GuiGui2401/CleverTreeSystem/README.md

# CleverTreeSystem

An application for monitoring plantations coupled with a physical device and created for web and mobile platforms

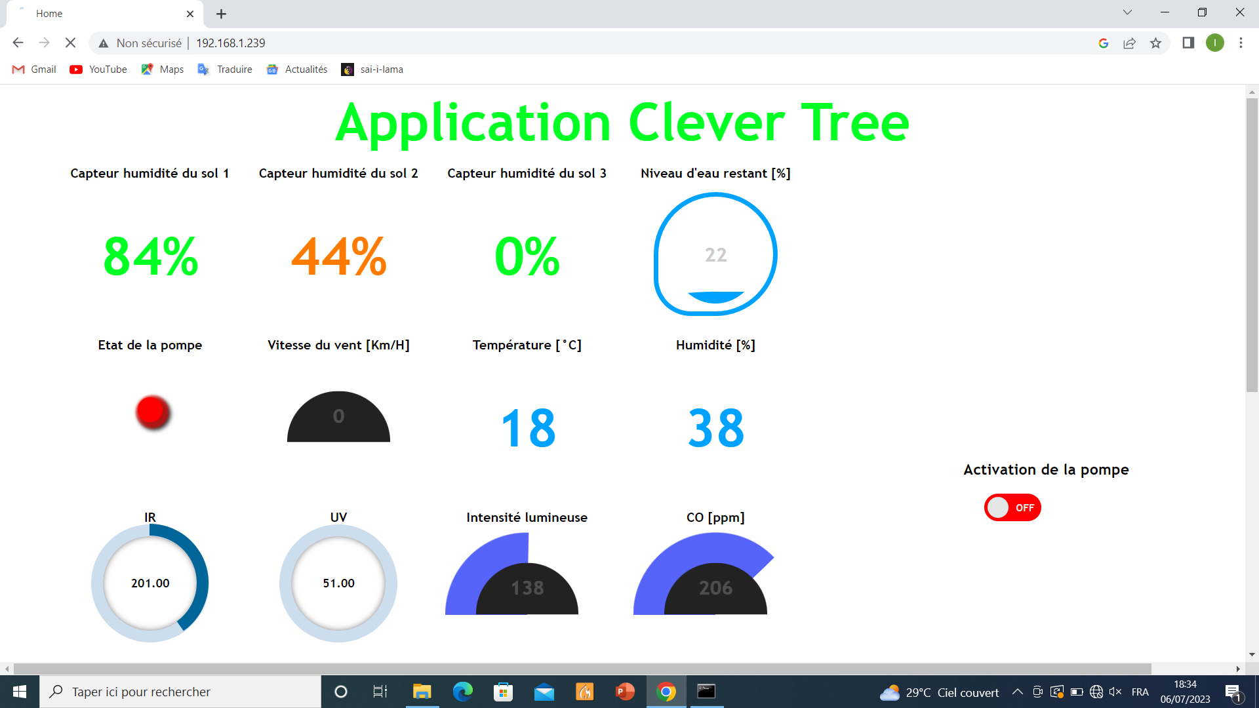
[picture p1: DOC/System_Test/Capture2.PNG]


- Made with Arduino, Java Android and Native Web integrated into Arduino language 💙

## That's the electrical diagram

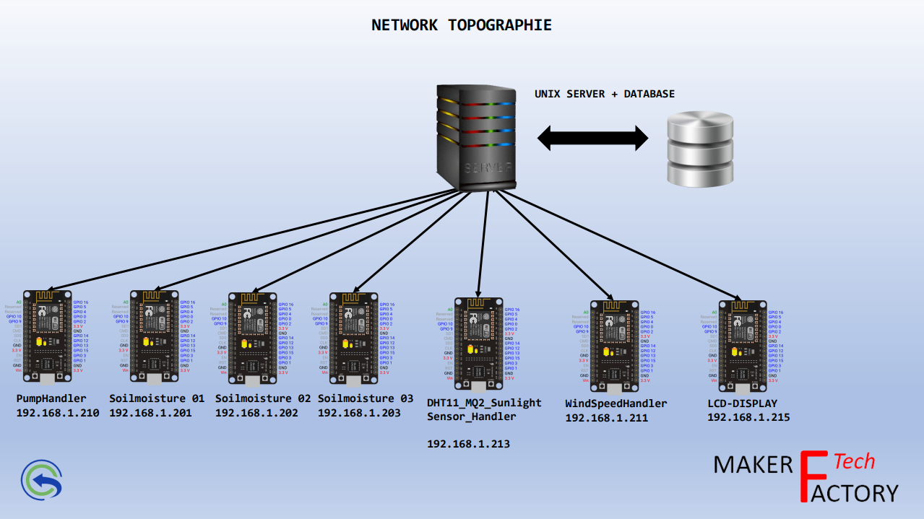
[picture p2: DOC/Electrical_Diagram/ElectricalDiagramCover.png]


## And that's the UML diagram

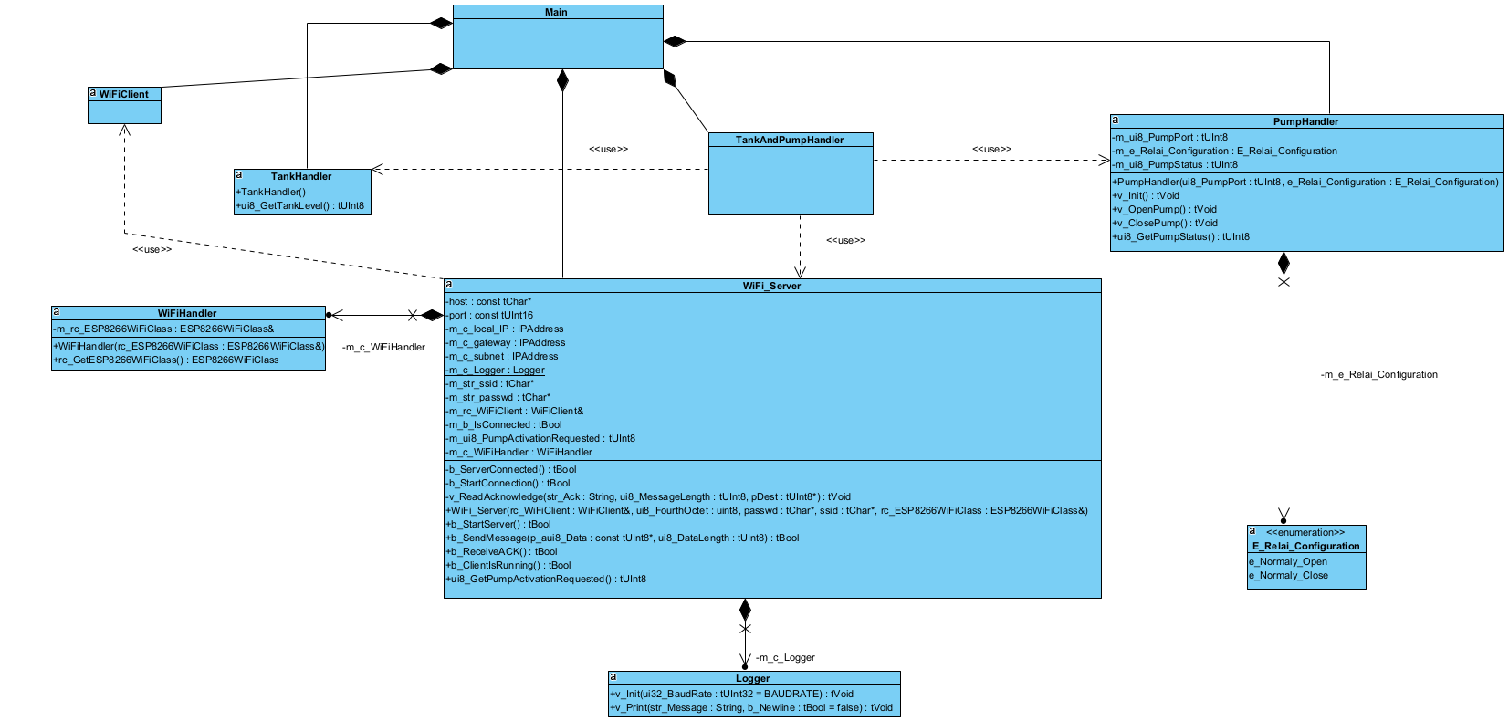
[picture p3: DOC/UML/TankAndPumpHandler.png]


## Developed By

- [GuiGui2401](https://github.com/GuiGui2401)
