GuiGui2401/CleverTreeSystem/DOC/Electrical_Diagram/Schema circuit electronique.pdf

## NETWORK TOPOGRAPHIE

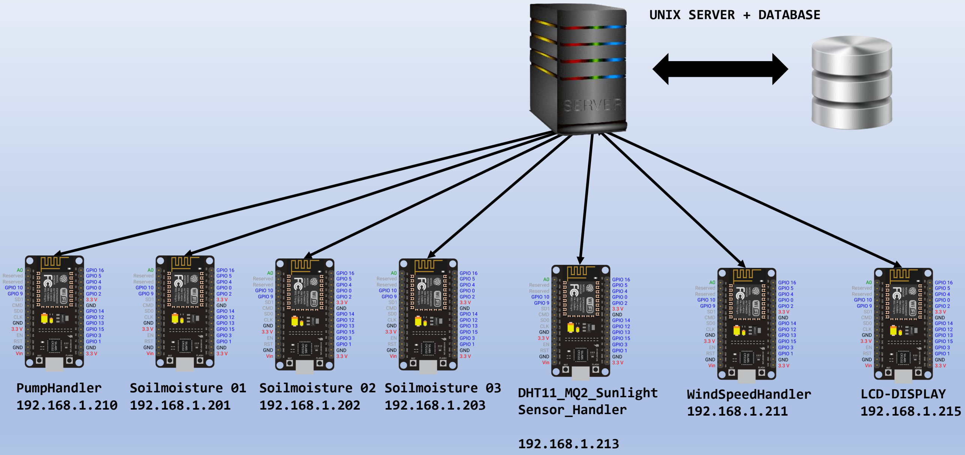
[picture p4: figure]
UNIX SERVER + DATABASE; PumpHandler 192.168.1.210; Soilmoisture 01 192.168.1.201; Soilmoisture 03 192.168.1.203; Soilmoisture 02 192.168.1.202; DHT11_MQ2_Sunlight Sensor_Handler; WindSpeedHandler 192.168.1.211; LCD-DISPLAY 192.168.1.215

## PumpHandler

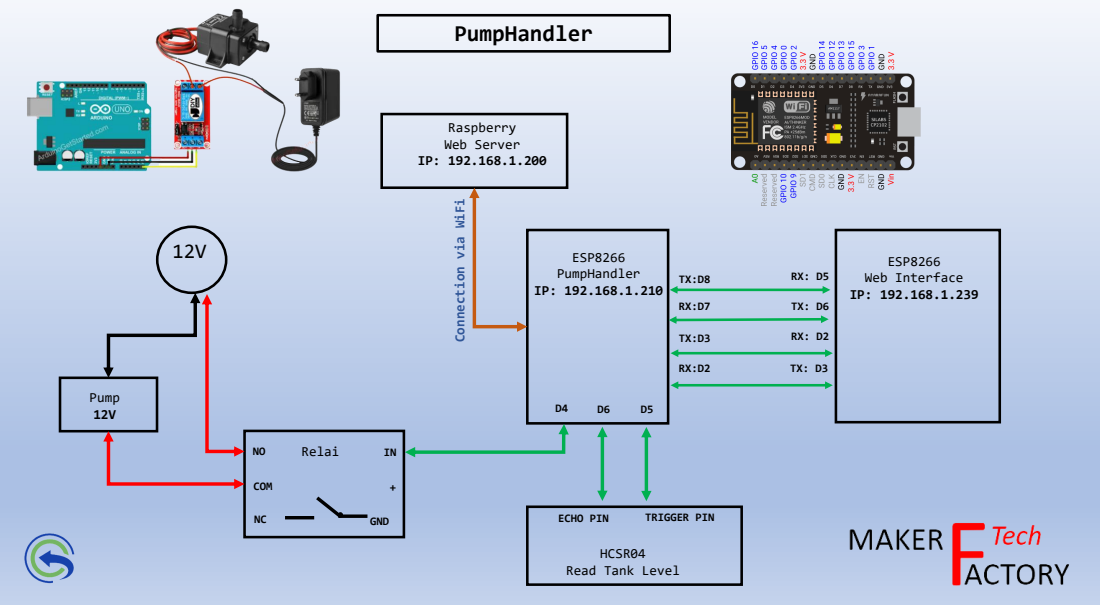
[picture p5: page 2]
ESP8266 PumpHandler IP: 192.168.1.210; ESP8266 Web Interface IP: 192.168.1.239; Raspberry Web Server; Relai; ECHO PIN; TRIGGER PIN; Pump 12V; COM; GND

IP: 192.168.1.200 Connection via WiFi

HCSR04
Read Tank Level

ESP8266
Soilmoisture Handler
IP: 192.168.1.20x

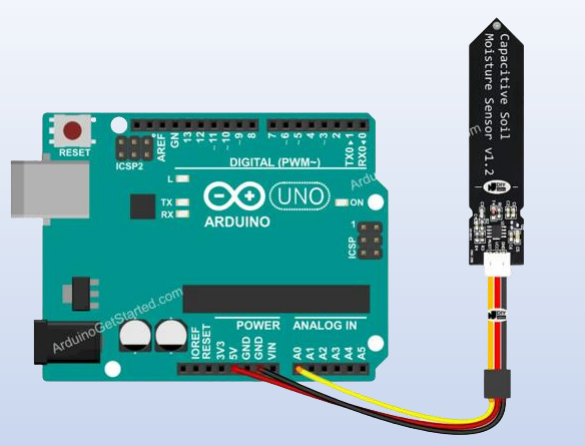
[picture p6: figure]

Soilmoisture Sensor A0

## Soilmoisture Handler

Raspberry
Web Server

IP: 192.168.1.200 Connection via WiFi

## DHT11_MQ2_SUNLIGHTSENSOR Handler

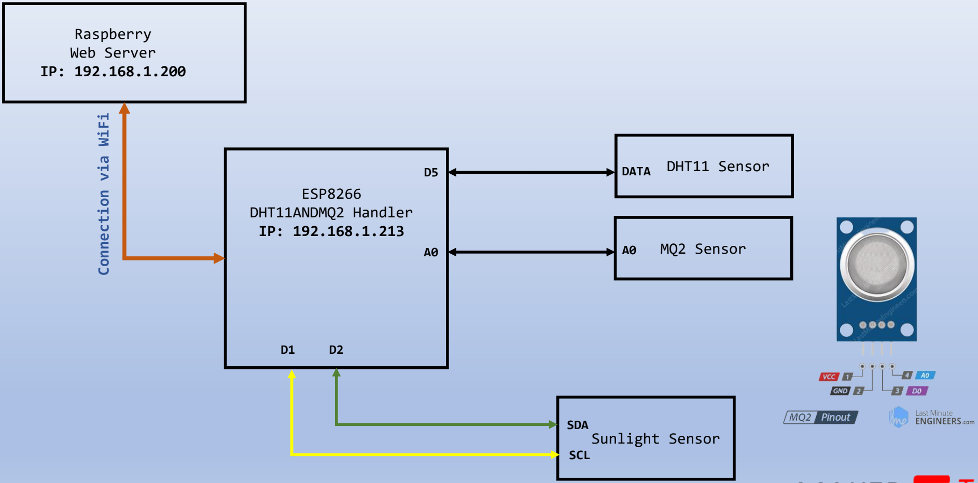
[picture p7: figure]
ESP8266 DHT11ANDMQ2 Handler IP: 192.168.1.213; DHT11 Sensor D5; Raspberry Web Server; IP: 192.168.1.200 Connection via WiFi; MQ2 Sensor; DATA; Sunlight Sensor; SDA; SCL

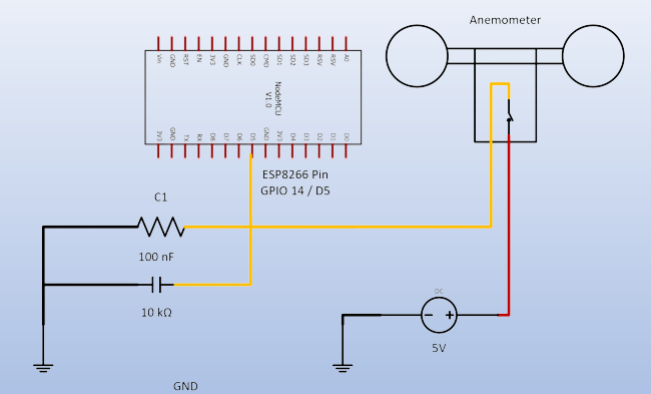
[picture p8: figure]

ESP8266
Wind Speed Handler
IP: 192.168.1.211

## Wind Speed Handler

Raspberry
Web Server

IP: 192.168.1.200 Connection via WiFi

GREEN Anemometer
PIN

D5

## LCD-Handler

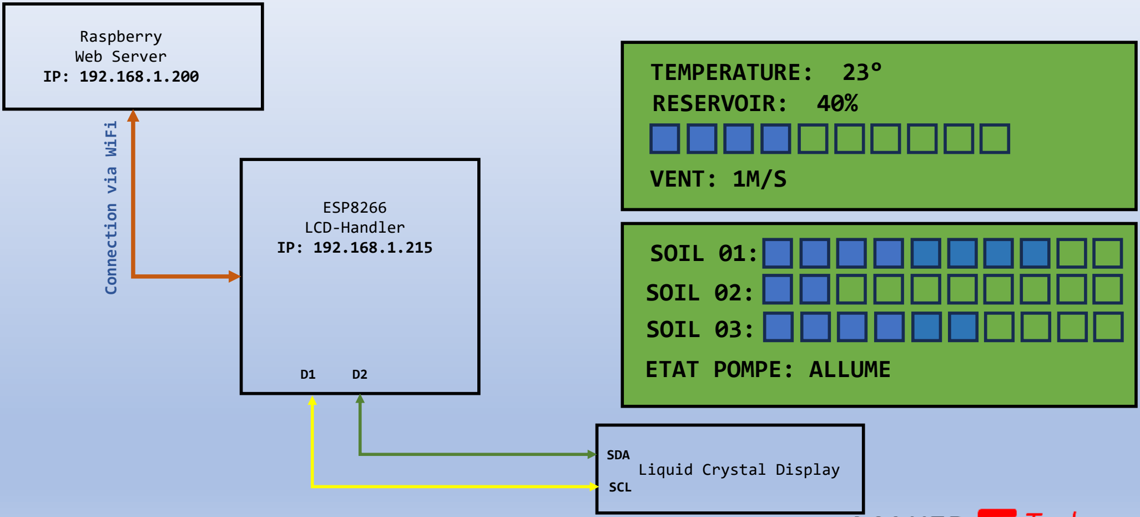
[picture p9: figure]
ESP8266 LCD-Handler IP: 192.168.1.215; Raspberry Web Server; IP: 192.168.1.200 Connection via WiFi; Liquid Crystal Display; SDA; SCL; TEMPERATURE: 23° RESERVOIR: 40%; VENT: 1M/S; SOIL 01:; ETAT POMPE: ALLUME; SOIL 02: SOIL 03:

## Webinterface

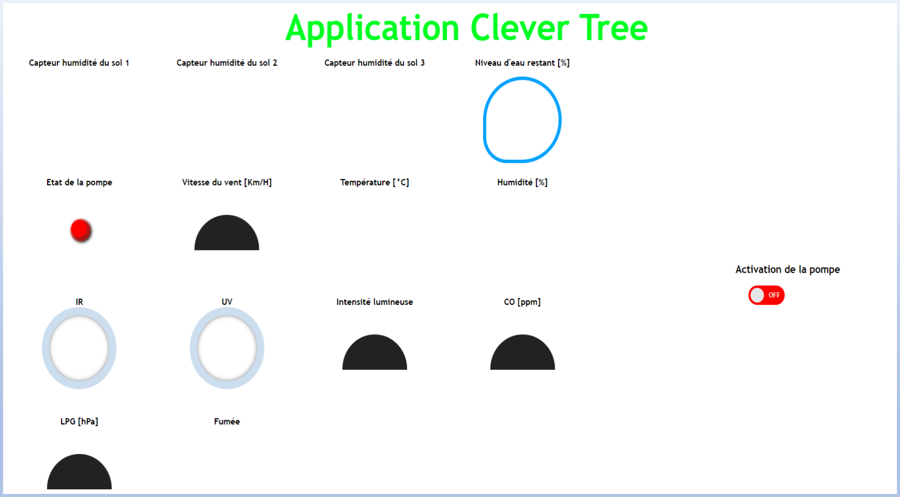
[picture p10: figure]
