GuiGui2401/CleverTreeSystem/DOC/Msg_send_from_server.png

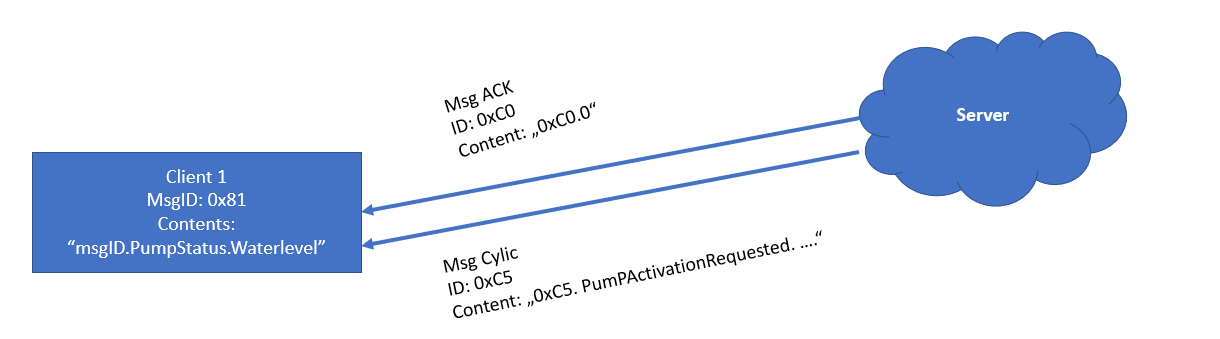
DOC/Msg_send_from_server.png
