GuiGui2401/CleverTreeSystem/src/Web/data/inno.png

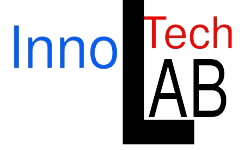
src/Web/data/inno.png
