GuiGui2401/CleverTreeSystem/src/Web/img/Capture d’écran (255).png

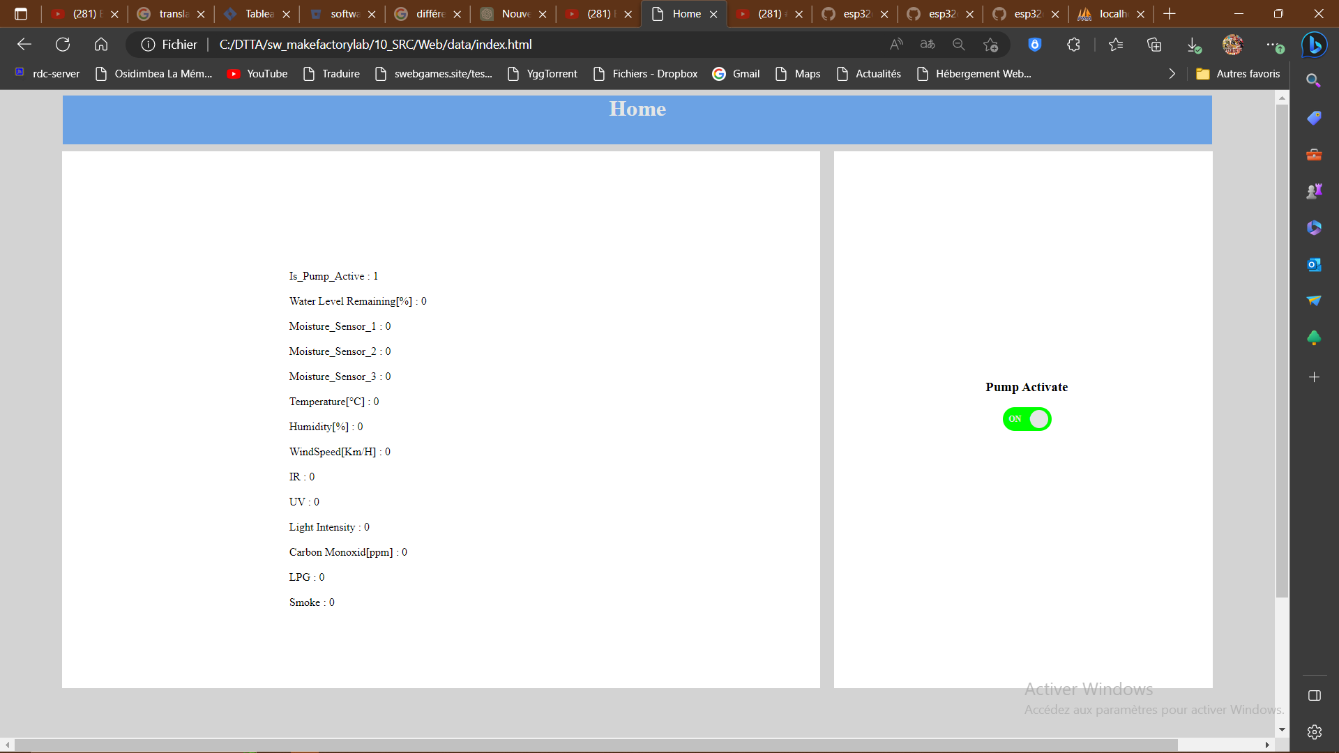
src/Web/img/Capture d’écran (255).png
