GuiGui2401/CleverTreeSystem/DOC/System_Test/Clevertree_Systemtest.xlsx

Sheet: Summary
Test description: | Test information:
Test the 100% SW delivery. We expect that all the ESP8266 can be connected to the server. They can send and receive the ack | Tester: | Jonathan Guiyoba
 | Date: | 2023-07-06
 | Clevertree Software version: | SW_CleverTree_X110
 | Test coverage | 92.31%
 | Test cases | 26
 | Realized | 24
 | Test passed | 23
 | Passed | 88.46%
Comments: | Test failed | 1
 | Failed | 3.85%
 | Test not tested | 2
 | Not tested | 7.69%
 | Attribut "Test Result"
 | Not Tested
 | OK
 | Not OK
 | Clarification
 | No result Expected
 | Attribut "Test Level"
 | 1 | Prototyp, safety not included

Sheet: Systemtest
TestID | Test Level |  | Test Case Name | Test Case Description | Precondition | Action | Expected Result | Test Result | Observation | Comment
 | Server
CleverTree_1 | 1 | manuall | server reachability check | Test if the server is running and reachable | P1: the multimedia card is booted and inserted into the Raspberry P2: The Raspberry is connected to a screen via HDMI P3: The Raspberry is connected to the router by ethernet cable P4: Raspberry configured at address 192.168.1.200 P5: Router is powered on |  | ER1: Server starts after Raspberry Pi starts ER2: The Server can be reached via the network ER3: The Database is created ER4: The Logfiles with the current timestamp is created ER5: The File /home/pi/logs/log.txt is created with 0 byte size | ok | En écrivant dans la base de donnée on essaye de lire un index qui est supérieur à la taille max du datacontent et ça génère l'erreur. Le with open a été oublier pour le logfile.
 | Pump
CleverTree_2 | 1 | manuall | Server connectivity test | It is tested if the client pump and tank handler connects to the server successfully. | P1: The ESP8266 contains the last software delivered and is in operation P2: The server is running | A1: Open Putty: Speed = 115200; COM = <must be determined by yourself> | ER1: The following messages are visible in the Serial Terminal - "Connected to server" - "INIT DONE" ER2: Checks in the file /home/pi/shp/Raspberry/LogFiles/serverLog_<datatime>.txt, if the connection with IP-Adress 192.168.1.210 has been entered. | ok
CleverTree_3 | 1 | manuall | Read the tank level each 5 minutes | Test if the Tank level is read each 5 minutes | P1: The ESP8266 contains the last software delivered and is in operation P2: The server is running P3: The water reservoir is half full | A1: Set the variable m_b_PumpRequest to default false in the TankAndPumpHandler.b_OnDuring() function A2: Build and Upload the software on the ESP8266 again A3: Open Putty: Speed = 115200; COM = <must be determined by yourself> A4: fill up the water reservoir until it is full | ER1: The Tank level can be observed in PuttY every 5 minutes ER2: The following message can be observed "TAPH: WaterTank Level: 50 Percent" ER3: The following message can be observed "TAPH: WaterTank Level: 100 Percent" | ok | La première tentative n'a pas fonctionner et lorsqu'on a ajouter un serialprint() ça a fonctionner.
CleverTree_4 | 1 | manuall | Connection Lost | Test after the connection is established, the client is disconnected to the server | P1: The ESP8266 contains the last software delivered and is in operation P2: The server is running P3: The Server GUI is opened | A1: Open the Putty Baudrate = 115200 A2: stop the server with a keyboard interrupt ctrl+C A3: Restart the server after the ER1 is observed | ER1: the following message can be seen on the serial monitor "WS: Connection lost, try to connect..." ER2: The connection to client is established and message can be sent | ok | Lorsque la connection est perdu on doit réinitialiser tout les flags.
CleverTree_5 | 1 | manuall | Sending to server and receiving ACK in client | The sending of the Pump_Status_Message (0x81) and the receiving of Acknowledge server is observed | P1: The ESP8266 contains the last software delivered and is in operation P2: The server is running P3: The Server GUI is opened | A1: Open serial monitor | ER1: The message with the IP address 192.168.1.210 should be visible in the log file. ER2: The message is visible in the serial terminal "[TX] ID=%.2X OK" ER3: The message is visible in the serial terminal "WS: Rx[ACK] for ID:%.2X OK" | ok
CleverTree_6 | 1 | manuall | Activate the pump via the server | It is checked if the pump can be activated by the server. | W | A1: revert your change in test CleverTree_3 A2: Build and Upload the software on the ESP8266 again A3: Set the value of m_ui8_SoilMoistureValue in the SoilMoistureMeasurement.ui8_ReadSoilMoistureValue() function to default 50 and flash the Soilmoisture ESP8266 again A4: Open Putty: Baudrate = 115200; COM = <must be determined by yourself> A5: Set the value of m_ui8_SoilMoistureValue in the SoilMoistureMeasurement.ui8_ReadSoilMoistureValue() function to default 29 and flash the Soilmoisture ESP8266 again | ER1: The pump is activated ER2: The pump is deactivated | ok | Le type uint_8 est trop petit pour la valeur du soil moisture vu qu'elle va jusqu'à 1024 donc elle doit être codé sur 16 bits au lieu de 8 bits. La valeur d'initialisation du soil moisture a été remplacer par 255 au lieu de 0 à cause d'une erreur au lancement. A la phase d'initialisationj on doit d'abord lire la valeur de réservoir. La fonction pour lire le temps de l'état ne fonctionne pas comme il se doit.
CleverTree_7 | 1 | manuall | Serial communication check | test if the pump can send / read message via serial communication | P1: The ESP8266 contains the last software delivered and is in operation P2: The server is running P3: The Server GUI is opened P4: The Webinterface is running (Pump ---> WebInterface) ---------------------------- ( D7 ---> D6 ) ( D8 ---> D5 ) ( D2 ---> D3 ) ( D3 ---> D2 ) | A1: open the serial monitor for PumpHandler and Webinterface | ER1: Message "WEB: length= Seq Number= WEB: Message received= " can be read in the serial monitor for each sequence (0 to 3) ER2: Message "WS: ACK receive for Seq " can be read in the serial monitor for each sequence (0 to 3) | ok
CleverTree_8 | 1 | manuall | Activate the Server via Serial communication (WebInterface) | It should be checked that the pump is activated when requested via serial communication | P1: The pump is in operation P2: The pump is deactivated P3: The Webinterface is running | A1: Set the return value of the function ui8_GetPumpActivationRequested to default false A2: Build and Upload the software on the ESP8266 again A3: Open serial monitor: Speed = 115200; COM = <must be determined by yourself> A4: Activate / Deactivate via the webinterface | ER1: The pump is activated ER2: The pump is deactivated | ok | L'état de la pompe doit être envoyé à chaque séquence ainsi que la demande d'activation de la pompe doit être envoyé sut tout les ports série.
CleverTree_9 | 1 | manuall | Pump activate when the level is low | It is checked that the pump is not activated when the level is low | P1: The pump is in operation P2: The pump is deactivated | A1: Empty the tank A2: Open Serial Monitor: Speed = 115200; COM = <must be determined by yourself> A3: Activate / Deactivate via the server. Set the value of m_ui8_SoilMoistureValue in the SoilMoistureMeasurement.ui8_ReadSoilMoistureValue() function to default 50 and flash the 3 Soilmoisture ESP8266 again then change this value to 29 for one of them and flash it again A4: Activate / Deactivate via the webinterface | ER1: The pump remains deactivated | ok
CleverTree_10 | 1 | manuall | Deactivation of the pump during the watering process due to low water level | It is checked if the pump is deactivated during irrigation because the tank level is less than 5% | P1: The pump is in operation P2: The pump is deactivated | A1: Fill the tank up to 6-10%. the fill level can be observed in PuttY A2: Open Serial Monitor: Speed = 115200; COM = <must be determined by yourself> A3: Activate / Deactivate via the server. Set the value of m_ui8_SoilMoistureValue in the SoilMoistureMeasurement.ui8_ReadSoilMoistureValue() function to default 50 and flash the 3 Soilmoisture ESP8266 again then change this value to 29 for one of them and flash it again or Activate / Deactivate via the webinterface A4: Repeat the action A2 until the level is < 5%. | ER1: If the level is < 5%, the pump is deactivated | not tested
 | Soilmoisture 01
CleverTree_11 | 1 | manuall | Server connectivity test | It is tested if the client soilmoisture successfully connects to theserver. | P1: The ESP8266 contains the last software delivered and is in operation P2: The server is running | A1: Open Putty: Speed = 115200; COM = <must be determined by yourself> | ER1: The following messages are visible in the Serial Terminal - "Connected to server" - "INIT DONE" ER2: Checks in the file /home/pi/shp/Raspberry/LogFiles/serverLog_<datatime>.txt, if the connection with IP-Adress 192.168.1.201 has been entered. | ok
CleverTree_12 | 1 | manuall | Read soil mosture value | It is checked if the soil moisture is read | P1: The ESP8266 contains the last software delivered and is in operation P2: The server is running | A1: Open Putty: Speed = 115200; COM = <must be determined by yourself> | ER1: The soil moisture value can be observed in PuttY | ok |  | Le soil moisture envoie la requête de pompe mâis la pompe ne s'active pas. On a dû calibrer le soil moisture avec les valeurs entre 0 et 600
CleverTree_13 | 1 | manuall | Sending to server and receiving ACK in client | The sending of the soil_Moisture_Message (0x82) and the receiving of Acknowledge server is observed | P1: The ESP8266 contains the last software delivered and is in operation P2: The server is running P3: The Server GUI is opened | A1: Open serial monitor | ER1: The message with the IP address 192.168.1.201 should be visible in the log file. ER2: The message is visible in the serial terminal "[TX] ID=%.2X OK" ER3: The message is visible in the serial terminal "WS: Rx[ACK] for ID:%.2X OK" | ok
 | DHT11, MQ2, Sunlightsensor
CleverTree_14 | 1 | manuall | Server connectivity test | It is tested if the client DHT11 successfully connects to theserver. | P1: The ESP8266 contains the last software delivered and is in operation P2: The server is running | A1: Open Putty: Speed = 115200; COM = <must be determined by yourself> | ER1: The following messages are visible in the Serial Terminal - "Connected to server" - "INIT DONE" ER2: Checks in the file /home/pi/shp/Raspberry/LogFiles/serverLog_<datatime>.txt, if the connection with IP-Adress 192.168.1.213 has been entered. | ok
CleverTree_15 | 1 | manuall | Read DHT11 Value | Test if the DHT11 sensor values are read | P1: The ESP8266 contains the last software delivered and is in operation P2: The server is running | A1: Open Putty: Speed = 115200; COM = <must be determined by yourself> | ER1: The Temperature and Humidity value can be observed in PuttY | ok
CleverTree_16 | 1 | manuall | Read MQ2 Value | Test if the MQ2 sensor values are read | P1: The ESP8266 contains the last software delivered and is in operation P2: The server is running | A1: Open Putty: Speed = 115200; COM = <must be determined by yourself> | ER1: CO, LPG and Smoke values can be observed in PuttY | ok
CleverTree_17 | 1 | manuall | Read Sunlight Sensor Value | Test if the Sunlight sensor values are read | P1: The ESP8266 contains the last software delivered and is in operation P2: The server is running | A1: Open Putty: Speed = 115200; COM = <must be determined by yourself> | ER1: IR, UV and Visible values can be observed in PuttY | nok | Le capteur a une défaillance et est donc inutilisable pour les tests.
CleverTree_18 | 1 | manuall | Sending to server and receiving ACK in client | The sending of the DHT11_Data_Message (0x80) and the receiving of Acknowledge server is observed | P1: The ESP8266 contains the last software delivered and is in operation P2: The server is running P3: The Server GUI is opened | A1: Open serial monitor | ER1: The message with the IP address 192.168.1.213 should be visible in the log file. ER2: The message is visible in the serial terminal "[TX] ID=%.2X OK" ER3: The message is visible in the serial terminal "WS: Rx[ACK] for ID:%.2X OK" | ok
 | WindSpeedHandler
CleverTree_19 | 1 | manuall | Server connectivity test | Test if the ESP8266 for the anenometer is connected to the server | P1: The ESP8266 contains the last software delivered and is in operation P2: The server is running | A1: Open Putty: Speed = 115200; COM = <must be determined by yourself> | ER1: The following messages are visible in the Serial Terminal - "Connected to server" - "INIT DONE" ER2: Checks in the file /home/pi/shp/Raspberry/LogFiles/serverLog_<datatime>.txt, if the connection with IP-Adress 192.168.1.211 has been entered. | ok
CleverTree_20 | 1 | manuall | Read Value from anenometer | Test if the DHT11 sensor values are read | P1: The ESP8266 contains the last software delivered and is in operation P2: The server is running | A1: Open Putty: Speed = 115200; COM = <must be determined by yourself> | ER1: windspeed value can be observed in PuttY | ok | La valeur d'attente a du être modifier de 10000 à 3
CleverTree_21 | 1 | manuall | Sending to server and receiving ACK in client | The sending of the WindSpeed Data Message (0x84) and the receiving of Acknowledge server is observed | P1: The ESP8266 contains the last software delivered and is in operation P2: The server is running P3: The Server GUI is opened | A1: Open serial monitor | ER1: The message with the IP address 192.168.1.211 should be visible in the log file. ER2: The message is visible in the serial terminal "[TX] ID=%.2X OK" ER3: The message is visible in the serial terminal "WS: Rx[ACK] for ID:%.2X OK" | ok
 | Time Measurement
CleverTree_22 | 1 | manuall | Latency measurement | Test the latency time between the send of message and the time to get a acknowledge of the sent message | P1: Server is running | A1: Connect all the ESP to a PC via USB Cable A2: run the file EnableTimeMeasuremnt.py in cmd to enable the TIME_MEASUREMENT and flash all the ESP8266 with his latest sw version A3: Open Tera Term, BAUDRATE = 152000 A4: Copy the screen for each Tera Term window and paste in a blank file and save it in a own folder for analysis. the file name must have the name of the Handler and the record start time e.g. PumpHandler_300620232029.txt | Only for analysis to Improve the SW | not tested |  | For this test an USB-Hub with extra power supply are needed
 | Webinterface
CleverTree_23 | 1 | manuall | Reachability test | Test if the webinterface is reachable | P1: WebInterface is running P2: the ESP8266 is flashed with the latest release SW and are working correctly | A1: open the cmd shell on your pc A2: run the command "ping -t 192.168.1.239" | ER1: all the packet are sent and < 2 are lost | ok
CleverTree_24 | 1 | manuall | Data received | Test if all data sent from the server arrives in the web interface | P1: WebInterface is running | A1: run the file DisableTimeMeasuremnt.py in cmd to disable the TIME_MEASUREMENT and flash all the ESP8266 with the software again A2: Compare the sending message and the receiving message | ER1: The data is every 30 seconds at the earliest and every 30 seconds at the latest available every 45 seconds ER2: The sending message and the receiving message are the same | ok
CleverTree_25 | 1 | manuall | Pump Activation | Test if the pump can be activated via the button on the webinterface | P1: WebInterface is running P2: the server is running P3: The PumpHandler is working P4: Pump is connected and not activ | A1: activate the Pump via the button on the webinterface A2: deactivate the Pump via the button on the webinterface | ER1: The pump is activated ER2: The pump is deactivated | ok
CleverTree_26 | 1 | manuall | Pump Activation Tank under 5% | Test if the pump can be activated via the button on the webinterface, if the tank level is under 5% | P1: WebInterface is running P2: the server is running P3: The PumpHandler is working P4: Pump is connected and not activ P5: The Tanklevel is smaller than 5% | A1: activate the Pump via the button on the webinterface A2: deactivate the Pump via the button on the webinterface | ER1: The pump is deactivated ER2: The pump is deactivated | ok
