GuiGui2401/CleverTreeSystem/DOC/Liste materiel.xlsx

Designation | Unité | Quantité | Total | URL
NodeMCU Lua Lolin V3 Module ESP8266 ESP-12F WIFI Wifi Development Board mit CH340 | 4.19 € | 7 | 29.33 € | https://www.az-delivery.de/products/nodemcu-lolin-v3-modul-mit-esp8266?variant=6127967895579
RASPBERRY PI 3 Raspberry Pi 3 B, 4x 1,2 GHz, 1 GB RAM, WLAN, BT | 49.50 € | 1 | 49.50 € | https://www.reichelt.de/raspberry-pi-3-b-4x-1-2-ghz-1-gb-ram-wlan-bt-raspberry-pi-3-p164977.html?PROVID=2788
TP-Link mobiler Router TL-MR3020 3G Wifi | 18.32 € | 1 | 18.32 € | https://www.kaufland.de/product/367433929/
VALUE 21991924 Patchkabel Cat.6a S/FTP PIMF rot 0.3m | 1.80 € | 1 | 1.80 € | https://www.reichelt.de/patchkabel-cat-6a-s-ftp-pimf-rot-0-3m-value-21991924-p333373.html?trstct=pol_10&nbc=1
DEBO RELAIS 2CH Entwicklerboards - Relais-Modul, 2 Channel, 5 V, SRD-05VDC-SL-C | 3.60 € | 1 | 3.60 € | https://www.reichelt.de/entwicklerboards-relais-modul-2-channel-5-v-srd-05vdc-sl-c-debo-relais-2ch-p242810.html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
TSSS DC 12V 4.8 W Mini Brushless Submersible Pumpe Wasserpumpe Kreiselpumpe 240L/H Aquarium Garten Fall Fisch Behälter Wasser Brunnen Unterhaltung, Düsendurchmesser 8 mm, Ohne Stecker | 13.99 € | 1 | 13.99 € | https://www.amazon.de/TSSS-Wasserpumpe-Submersible-Gartenteich-Unterhaltung/dp/B01I9BN3CI?hvadid=309841835255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
Amzeeniu 149 PCS Bewässerung Kit,30m Garten Micro Drip Bewässerung Automatik Bewässerung Kit Schlauch Tröpfchenbewässerung DIY Gartenbewässerung für Landschaft,Flower Bed,Terrasse Pflanzen | 20.99 € | 1 | 20.99 € | https://www.amazon.de/Amzeeniu-Bew%C3%A4sserung-Tr%C3%B6pfchenbew%C3%A4sserung-Gartenbew%C3%A4sserung-Landschaft/dp/B08YWLLMK5
HC-SR04 Ultraschall Modul Entfernungsmesser Sensor für Raspberry Pi | 2.09 € | 1 | 2.09 € | https://www.az-delivery.de/products/3er-set-hc-sr04-ultraschallmodule?variant=6107570372635
Bodenfeuchtesensor Hygrometer Modul V1.2 kapazitiv kompatibel mit Arduino und Raspberry Pi | 2.49 € | 3 | 7.47 € | https://www.az-delivery.de/products/bodenfeuchte-sensor-modul-v1-2?variant=12461193920608
KY-015 DHT 11 Temperatursensor Modul | 2.39 € | 1 | 2.39 € | https://www.az-delivery.de/products/dht-11-temperatursensor-modul?variant=8184942035040
MQ-2 Gas Sensor Rauch Sensor Luftqualität Modul | 2.89 € | 1 | 2.89 € | https://www.az-delivery.de/products/gas-sensor-modul?variant=8188900966496
seeed Grove - Sonnenlichtsensor (UV-Licht, sichtbares Licht und Infrarotlicht) - SI1145 | 10.10 € | 1 | 10.10 € | https://www.berrybase.de/seeed-grove-sonnenlichtsensor-uv-licht-sichtbares-licht-und-infrarotlicht-si1145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
Roundsky WH-WS01 Wind Geschwindigkeits Mess GeräT Wind Geschwindigkeits Meteorologisches Instrumenten ZubehöR für | 28.99 € | 1 | 28.99 € | https://www.amazon.de/Roundsky-WH-WS01-Geschwindigkeits-Meteorologisches-Instrumenten/dp/B0BB792HX4
HD44780 2004 LCD Display Bundle 4x20 Zeichen mit I2C Schnittstelle | 6.66 € | 1 | 6.66 € | https://www.az-delivery.de/products/hd44780-2004-lcd-display-bundle-4x20-zeichen-mit-i2c-schnittstelle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
Zelsius Folien Gewächshaus mit 8 Ablagen, 195x143x143 cm, Tomatenhaus | 59.95 € | 1 | 59.95 € | https://www.kaufland.de/product/324271072/?vid=359356123
YAUNGEL Zimmergewächshaus Anzuchtkasten, 6 Stück 72 Zellen Mini Gewächshaus Anzucht Set Setzling Starter Tabletts Treibhaus Anzuchtschale mit Deckel und Belüftung für Sämling Pflanze, Grün | 14.78 € | 1 | 14.78 € | https://www.amazon.de/YAUNGEL-Zimmergew%C3%A4chshaus-Anzuchtkasten-Gew%C3%A4chshaus-Anzuchtschale/dp/B08MFCFKT8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
RPI FAN 30X30 Raspberry Pi - Lüfter 30x30x10 mm für NESPI und SNESPI-Gehäuse | 3.65 € | 3 | 10.95 € | https://www.reichelt.de/raspberry-pi-luefter-30x30x10-mm-fuer-nespi-und-snespi-gehaeuse-rpi-fan-30x30-p211466.html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
SDSQUA4032GGN6MA MicroSDHC-Speicherkarte 32GB, SanDisk Ultra | 5.95 € | 1 | 5.95 € | https://www.reichelt.de/microsdhc-speicherkarte-32gb-sandisk-ultra-sdsqua4032ggn6ma-p297179.html?PROVID=2788
 |  |  | 0.00 €
 |  |  | 0.00 €
 |  |  | 289.75 €
