GuiGui2401/CleverTreeSystem/DOC/ETH_Message_CleverTree.xlsx

Sheet: Cover
Server Messages Clever WiFi
Project number: | -
Project name: | Clevertree
Project name short: | -
Project manager: | Gerald Emvoutou
Customer: | intern
File name: | ETH_Message_CleverTree.xlsx
Document version: | 1.0
Document date: | 01/04/2023
Confidentiality classification: | Confidential
Document status: | in work
Department: | -
Author: | Gerald Emvoutou
Phone number:
Email: | cezy.emvoutou@dta-alliance.com
Change documentation
Subject |  | Editor | Approval | Date | Version
Initial message definition at project kick-off |  | Gerald Emvoutou | - | 2021-10-10 | 1.00
Template: <insert file name of template here> |  |  |  |  | Template version x.x

Sheet: Server Messages Server -Client
Message | Description (This column is NOT a requirement specification.) | Sender | Receiver | MsgID | Acknowledge required | Parameters | Additional hints
Cyclic Message | Cyclic message contains all the data, which stored on the server | Server | Client | 0xC5 | no | 0 ui8_MsgID 1Byte 1 ui8_PumPActivationRequested 1Byte 2 ui8_SoilMoistureValue_01 1Byte 3 ui8_SoilMoistureValue_02 1Byte 4 ui8_SoilMoistureValue_03 1Byte 5 ui8_WaterLevel 1Byte 6 ui8_PumpStatus 1Byte 7 ui8_WindSpeed 1Byte 8 ui8_Temperature 1Byte 9 ui8_Humidity 1Byte 10 ui8_IR 1Byte 11 ui8_UV 1Byte 12 ui8_Visible 1Byte 13 ui8_CO 1Byte 14 ui8_LPG 1Byte 15 ui8_Smoke 1Byte
DHT11 MQ2 Data Message | the message contains data from DHT11 and Windspeed sensor | client | server | 0x80 | yes | ui8_MsgID 1Byte ui8_Temperature 1Byte ui8_Humidity 1Byte ui8_CO 1Byte ui8_LPG 1Byte ui8_Smoke 1Byte ui8_IR 1Byte ui8_UV 1Byte ui8_Visible 1Byte
Pump Status Message | Cyclic message contains all the pump status | client | server | 0x81 | yes | ui8_MsgID 1Byte ui8_PumpStatus 1Byte ui8_WaterLevel 1Byte
Soil Moisture Message | the message contains data from Soil moisture sensor | client | server | 0x82 | yes | ui8_MsgID 1Byte ui8_PumpActivationRequested 1Byte ui8_SoilMoistureValue 1Byte
WindSpeed Data Message |  | client | Server | 0x86 | yes | ui8_MsgID 1Byte ui8_WindSpeed 1Byte
~~MQ2 Data Message~~ |  | ~~client ~~ | ~~server~~ | ~~0x83~~ | ~~yes~~ | ~~ui8_MsgID 1Byte ~~
~~SunlightSensor Data Message~~ |  | ~~client ~~ | ~~server~~ | ~~0x84~~ | ~~yes~~ | ~~ui8_MsgID 1Byte ~~
LCD Message |  | client | server | 0x87 | no | ui8_MsgID 1Byte reservedbyte
ACK_Message_Server |  | Server | Client | 0xC0 | no | ui8_MsgID 1Byte reserved 1Byte ui8_ACKMsgID 1Byte ui8_ACK 1Byte | ui8_ACK = 0x00 no errors ui8_ACK = 0x01 errors ui8_ACK = 0x02
