GuiGui2401/CleverTreeSystem/DOC/Project_FactoryLab.xlsx

Sheet: Projet
Nom du Projet | Etat d'avancement | Responsable | Executant | Deadline | Description
CleverTree | en cours | Cezy | Jonathan | 2023-01-25 | D1: achevé le clever tree D2: Creer un web client pour le clever Tree D3:
Bande Lucas Nülle | non débuté | Cezy | Cezy | 2023-01-25 | D1: rendre les bandes operationnelle pour des demonstrations
Robot Didactique Fischer | non débuté | Cezy | Jean Blaise | 2023-01-25 | D1: rendre le robot operationnelle pour des demonstrations
Smarthome | non débuté | Cezy | Simplice | 2023-01-25 | D1: rendre le Smarthome operationnelle pour des demonstrations

Sheet: Module
Module | Etat d'avancement | Taux d'avancement
CleverTree
M1: Web Appli | non débuté | 0.00%
M2: Gestion Pompe et Reservoir de facon automatique | en cours | 66.67%
M3: Gestion Humidité du sol | en cours | 50.00%
M4: Socket Server | en cours | 62.50%
M5: Gestion Parametre environnementaux | non débuté | 0.00%
M6: Gestion Autonome energie | non débuté | 0.00%
Bande Lucas Nülle
M1: Installation | non débuté
M2: Reproduire les excercices | non débuté
M3: How-To-Tutorial | non débuté

Sheet: Version CleverTree
Date | Version | Modification
2023-01-01 | 1.1 | Creation
2023-01-19 | 1.2 | • Ajout R.4.1.9
2023-01-23 | 1.3 | • modification R.1.1.3 • ajout R.4.1.10
2023-01-24 | 1.4 | • ajout onglet ConfigurationGlobale • ajout R.4.1.11 • ajout R.4.1.12 • ajout R.4.1.13

Sheet: Requirements checkliste
Requirement ID | Requirement description | Status | Observation
 | PumpHandler
Req 1.1 | • PumpHandler est configuré avec l’adresse IP 192.168.1.210 | Satisfied
Req 1.2 | • PumpHandler envoi au serveur le message Pump Status Message | Satisfied
Req 1.3 | • Le taux de remplissage est verifie chaque 300000 millisecondes | Satisfied
Req 1.4 | • PumpHandler établi une connection serveur client | Satisfied
Req 1.5 | • PumpHandler n'envoi que des données au serveur que lorsqu'une connection avec celui est etabli et active dans le cas contraire le client tentera de se reconnecter au serveur | Satisfied
Req 1.6 | • La pompe ne peut être active uniquement que si le taux de remplissage est supérieur a 5% | Satisfied
Req 1.7 | • PumpHandler recoit un message venant du serveur qu il doit parser en 2 partie: la 1ère partie est constitué d'un message de confirmation de recpetion de la part du serveur et l'autre message est constitué des paramétre a envoyer a la web interface. • [MsgID].[reserved].[ACK_MsgID].[ACK_Status].[MsgID_CyclicMsg]. ..... (voir message ciclique ) | Satisfied
Req 1.8 | • La carte arduino TankAndPumpHandler s’active de façon automatique si une des conditions ci-dessous est vrai (OR-Connection) : - Le taux d’humidité d’un capteur de sol est inferieur a 30% - le serveur envoie une requete d'activation de la pompe a pumpHandler | Satisfied
Req 1.9 | • Le Relai de la pompe doit être configurer en normally-Open | Satisfied
Req 1.10 | • PumpHandler est connecté avec la web interface via communication serie • 3 softwareserial ports doivent etre definit pour cela (2 pour envoi vers webinterface , 1 pour reception) | Satisfied
Req 1.11 | • le message envoye vers la web interface est sequence en 4 partie • chaque sequence contient la longueur de la suite charactere et le numero de la sequence ainsi que les parametre a envoer • l envoi de la sequence suivante est conditionné par la recpetion de l ACK de la sequence precedente | Satisfied
Req 1.12 | • La pompe s’ouvre pour un délai d’une minute et le taux de remplissage du réservoir doit être contrôler pendant c est une minute pour éviter qu’il atteigne son niveau critique. | Satisfied
Req 1.13 | • Si pendant les 1 minutes durant laquelle la pompe est ouverte le taux de remplissage du réservoir est en dessous de 5% la pompe se ferme automatiquement. | Satisfied
 | SoilmoistureHandler
Req 2.1 | • SoilmoistureHandler est configuré avec l’adresse IP 192.168.1.20X | Not satisfied
Req 2.2 | • SoilmoistureHandler etabli une connection serveur client via WiFi | Not satisfied
Req 2.3 | • SoilmoistureHandler calcule en pourcentage le taux d’humidité du sol en fonction de sa valeur MIN et MAX préalablement détermine lors du calibrage | Not satisfied
Req 2.4 | • SoilmoistureHandler affiche au moniteur série le message « Pump activation requested » lorsque le taux d’humidité est en dessous de 30% | Not satisfied
Req 2.5 | • SoilmoistureHandler envoie au serveur le message Soil Moisture Message | Not satisfied
Req 2.6 | • Soilmoisturehandler attend un message ACK de confirmation de recpetion par le serveur pour pouvoir envoyer le message suivant | Not satisfied
Req 2.7 | • SoilmoistureHandler n'envoi que des données au serveur que lorsqu'une connection avec celui est etabli et active dans le cas contraire le client tentera de se reconnecter au serveur | Not satisfied
Req 2.8 | • SoilmoistureHandler envoi les informations au serveur chaque 60000 millisecondes | Not satisfied
 | WindSpeedHandler
Req 3.1 | • WindSpeedHandler est configuré a l'adresse IP 192.168.1.211 | Not satisfied
Req 3.2 | • WindSpeedHandler etabli une communication client server via WiFi | Not satisfied
Req 3.3 | • WindSpeedHandler n'envoi des données au serveur que lorsqu'une connection avec celui est etabli et activé dans le cas contraire le client tentera de se reconnecter au serveur | Not satisfied
Req 3.4 | • WindSpeedHandler envoi le message WindSpeed Data Message | Not satisfied
Req 3.5 | • WindSpeedHandler attend un message ACK de confirmation de recpetion par le serveur pour pouvoir envoyer le message suivant | Not satisfied
 | WebInterface
Req 4.1 | • La WebInterface est configuré à l'adresse IP: 192.168.1.239 | not satisfied
Req 4.2 | • La WebInterface est composée de jauge permettant de visualiser les paramètres du clevertree | not satisfied
Req 4.3 | • La WebInterface a travers un button permet d'activer la pompe manuellement | not satisfied
Req 4.4 | • La WebInterface s'actualise automatiquement chaque 30 secondes | not satisfied
Req 4.5 | • La WebInterface dispose d un boutton permettant de tout interrompre lorsqu il est activé | not satisfied
Req 4.6 | • La WebInterface lit les messages provenant du Pumphandler via la communication Serie | not satisfied
Req 4.7 | • La WebInterface disposent de 2 Sofwareserial port pour la lecture des messages entrant et 1 Softwareserial pour envoyer le message d'activation de la pompe ou le STOP | not satisfied
 | WebServer
Req 5.1 | • Le Webserveur est configuré à l'adresse IP: 192.168.1.100 | not satisfied
Req 5.2 | • Le Webserveur autorise uniquement les connections des client entre 192.168.1.128 - 192.168.1.240 | not satisfied
Req 5.3 | • Le Webserveur demarre par autostart et doit etre stopper par un process kill | not satisfied
Req 5.4 | • Le Webserveur recoit les differents message des clients les sauvegarde dans un Array et leur renvoi un ACK de confirmation | not satisfied
Req 5.5 | • Le Webserveur stocke egalement les données des clients dans une SQL DataBase | not satisfied
Req 5.6 | • Le message ACK_Web_Server est concatene avec le message Cyclic Message pour les ID 0x81 et 0x87 | not satisfied
Req 5.7 | • Lorsque le status de la pompe est passé de ON a OFF, le requete d'activation de la pompe est automatiquement remise à 0 | not satisfied
Req 5.8 | • Les differentes connections au serveur, les messages recu par le serveur et les messages de debug sont enregistré dans un fichier Log | not satisfied
Req 5.9 | • Les fichiers logs datant de plus de 2 semaines sont automatiquement supprimer | not satisfied
 | DHT11_MQ2_SunlightSensorHanlder Handler
Req 6.1 | • DHT11_MQ2_SunlightSensorHandler est configuré a l'adresse IP 192.168.1.213 | Not satisfied
Req 6.2 | • DHT11_MQ2_SunlightSensorHandler etabli une communication client server via WiFi | Not satisfied
Req 6.3 | • DHT11_MQ2_SunlightSensorHandler n'envoi des données au serveur que lorsqu'une connection avec celui est etabli et activé dans le cas contraire le client tentera de se reconnecter au serveur | Not satisfied
Req 6.4 | • DHT11_MQ2_SunlightSensorHandler envoi le message DHT11 MQ2 Data Message | Not satisfied
Req 6.5 | • DHT11_MQ2_SunlightSensorHandler attend un message ACK de confirmation de recpetion par le serveur pour pouvoir envoyer le message suivant | Not satisfied
Req 6.6 | The MQ2 sensor needs to be calibrated for 48 hours the first time it is used | Need to be clarified
Req 6.7 | A threshold must be determined | Not satisfied
Req 6.8 | When starting the SW, the MQ2 sensor has to wait 10 minutes before it starts sending data | Need to be clarified
 | LCD-Display
Req 8.1 | • LCD-Display est configuré a l'adresse IP 192.168.1.215 | Not satisfied
Req 8.2 | • LCD-Display etabli une communication client server via WiFi | Not satisfied
Req 8.3 | • LCD-Display recois les données du serveur et envoi un message "Lcd display ping" au serveur | Not satisfied
Req 8.4 | • LCD-Display affiche les parametres sur un display numerique | Not satisfied

Sheet: Server_Message_Mapping
Frame |  |  | Signal |  |  | Value |  |  |  |  |  |  |  | Sender - Receiver
Message | Identifier[hex] | Identifier[dez] | Signal | Byte Position | SignalLength (Byte) | Min Rawvalue | Max Rawvalue | Unité | OffSet | Initvalue | Invalidvalue | RawValue | Description | Serveur 192.168.1.200 | TankAndPumpHandler 192.168.1.210 | SurroundData 192.168.1.212 | SoilMoisture_Capteur 192.168.1.20X | LCD Display 192.168.1.213 | WindSpeed 192.168.1.211 | Signal comments
Data_01 | 0x01 | 1 | Data_PumpStatus | 0 | 1 | 0 | 1 | N/A | N/A | 0 |  | 0 1 | eteint allumé | S | R |  |  | R
Data_01 | 0x01 | 1 | Data_TankLevel | 1 | 1 | 0 | 100 | % | N/A | 0 | ≥ 101 | N/A | N/A | S | R |  |  | R
Data_01 | 0x01 | 1 | Data_SoilMoisture_01 | 2 | 1 | 0 | 100 | % | N/A | 255 | ≥ 101 | N/A | N/A | S | R |  |  | R
Data_01 | 0x01 | 1 | reserved | 3 | 1 | N/A | N/A | N/A | N/A | N/A | N/A | N/A | N/A | S | R |  |  | R
Data_01 | 0x01 | 1 | reserved | 4 | 1 | N/A | N/A | N/A | N/A | N/A | N/A | N/A | N/A | S | R |  |  | R
Data_01 | 0x01 | 1 | Data_Temperature | 5 | 1 | 0 | 50 | °C | N/A | 0 | N/A | N/A | N/A | S | R |  |  | R
Data_01 | 0x01 | 1 | Data_Humidity | 6 | 1 | 0 | 100 | % | N/A | 0 | ≥ 101 | N/A | N/A | S | R |  |  | R
Data_01 | 0x01 | 1 | Data_WindSpeed | 7 | 1 | 0 | 100 | KM/H | N/A | 0 | N/A | N/A | N/A | S | R |  |  | R
Data_01 | 0x01 | 1 | Data_InfraRed | 8 | 1 | 0 | N/A | N/A | N/A | 0 | N/A | N/A | N/A | S | R |  |  | R
Data_01 | 0x01 | 1 | Data_Ultraviolet | 9 | 1 | 0 | N/A | N/A | N/A | 0 | N/A | N/A | N/A | S | R |  |  | R
Data_01 | 0x01 | 1 | Data_Visible | 10 | 1 | 0 | N/A | N/A | N/A | 0 | N/A | N/A | N/A | S | R |  |  | R
Data_01 | 0x01 | 1 | Data_CarbonMonoxyd | 11 | 1 | 0 | N/A | N/A | N/A | 0 | N/A | N/A | N/A | S | R |  |  | R
Data_01 | 0x01 | 1 | Data_LPG | 12 | 1 | 0 | N/A | N/A | N/A | 0 | N/A | N/A | N/A | S | R |  |  | R
Data_01 | 0x01 | 1 | Data_Smoke | 13 | 1 | 0 | N/A | N/A | N/A | 0 | N/A | N/A | N/A | S | R |  |  | R
PumpStatus_01 | 0x02 | 2 | PS_PumpStatus | 0 | 1 | 0 | 1 | N/A | N/A | 0 | N/A | 0 1 | eteint allumé |  | S
PumpStatus_01 | 0x02 | 2 | PS_TankLevel | 1 | 1 | 0 | 100 | % | N/A | 0 | ≥ 101 | N/A | N/A |  | S
SurroundData_01 | 0x03 | 3 | SD_Temperature | 0 | 1 | 0 | 50 | °C | N/A | 0 | N/A | N/A | N/A |  |  | S
SurroundData_01 | 0x03 | 3 | SD_Humidity | 1 | 1 | 0 | 100 | % | N/A | 0 | ≥ 101 | N/A | N/A |  |  | S
SurroundData_01 | 0x03 | 3 | SD_InfraRed | 2 | 1 | 0 | N/A | N/A | N/A | 0 | N/A | N/A | N/A |  |  | S
SurroundData_01 | 0x03 | 3 | SD_Ultraviolet | 3 | 1 | 0 | N/A | N/A | N/A | 0 | N/A | N/A | N/A |  |  | S
SurroundData_01 | 0x03 | 3 | SD_Visible | 4 | 1 | 0 | N/A | N/A | N/A | 0 | N/A | N/A | N/A |  |  | S
SurroundData_01 | 0x03 | 3 | SD_CarbonMonoxyd | 5 | 1 | 0 | N/A | N/A | N/A | 0 | N/A | N/A | N/A |  |  | S
SurroundData_01 | 0x03 | 3 | SD_LPG | 6 | 1 | 0 | N/A | N/A | N/A | 0 | N/A | N/A | N/A |  |  | S
SurroundData_01 | 0x03 | 3 | SD_Smoke | 7 | 1 | 0 | N/A | N/A | N/A | 0 | N/A | N/A | N/A |  |  | S
WindSpeedData_01 | 0x04 | 4 | WS_WindSpeed | 0 | 1 | 0 | 100 | KM/H | N/A | 0 | N/A | N/A | N/A |  |  |  |  |  | S
SoilMoistureData_01 | 0x05 | 5 | SM_SoilMoisture_01 | 2 | 1 | 0 | 100 | % | N/A | 0 | ≥ 101 | N/A | N/A |  |  |  | S
